sinara-hw/KASLI-DIOT/README.md

# Kasli
Kasli is a low-cost FPGA system board, capable of controlling 8 DI/OT peripheral modules. It can act as either an ARTIQ central core device or a satellite connected to the master via DRTIO.

## Design Files

Design files (schematics, PCB layouts, BOMs) can be found at [Kasli/Releases](https://github.com/sinara-hw/Kasli/releases).

## Wiki

More information can be found on the [wiki](https://github.com/sinara-hw/Kasli/wiki).
