sinara-hw/KASLI-DIOT/(list of files, drawings)

Other design files:
Bank_12_14_35.SchDoc
Bank_13_15.SchDoc
Bank_16_32_36.SchDoc
CLK_buffer_DRTIO_CDR.SchDoc
ClockRecovery.SchDoc
Ext_conn.schdoc
FPGA.schdoc
FPGA_I2C.SchDoc
FPGA_SDRAM.SchDoc
FPGAGTP.SchDoc
Kasli-DIOT.PrjPCB
Kasli-DIOT.SchDoc
PowerSupplies.SchDoc
SERVMOD control.SchDoc
SFP.SchDoc
USB_Serial_Quad.SchDoc
