sinara-hw/KASLI-DIOT/(threads)

Thread 2 (2024-03-22):

SCH and PCB review

gkasprow, 2024-03-22:
- [x] Move the bootloader button closer to the edge
- [x] Mark 12V connector as DNP or move it to the back - now it obstructs the airflow
- [x] Route I2C to the mezzanine in case we want to add additional SFPs

filipswit, 2024-03-24:
> Move the bootloader button closer to the edge

I don't think we can move it closer. It can't fit under the panel. We can optionally move it on TOP.

> Mark 12V connector as DNP or move it to the back - now it obstructs the airflow

We can try to move it to the right. For the first proto it will be needed to work on the table, later might be unmounted.
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

gkasprow, 2024-03-24:
Nie musisz odrazu pprawiac issues. Pawel bedzie robil review i pewnie i tak
cos wyjdzie.

niedz., 24 mar 2024, 20:45 użytkownik filipswit ***@***.***>
napisał:

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

filipswit, 2024-11-10:
12V Connector moved, in future can be marked as DNP
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

Closed 2024-11-10.

Thread 11 (2024-05-09):

Keep slot signals in the same bank

marmeladapk, 2024-05-09:
If that's not possible then keep clock capable signals with the same byte (so lvds0 and lvds1-7 in the same bank and lvds8 and lvds 9-15 in the same bank).

filipswit, 2024-05-09:
Can you point which exactly are wrongly connected?

marmeladapk, 2024-05-14:
On a closer look I didn't find any problems. I must have misread signal names in bank 2.

Closed 2024-05-14.

Thread 4 (2024-05-09):

Add a buffer to clock input

marmeladapk, 2024-05-09:
Then in case of an overdrive the buffer will fail, not the FPGA.

Similar thing should be done on Kasli and Kasli SoC as well IMO.

gkasprow, 2024-05-09:
we can also use anti-parallel diodes like it's done in WR switch

filipswit, 2024-11-06:
How about placing FIN1101?
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

jordens, 2024-11-06:
Is the performance of that buffer (phase noise, tempco, etc) known to be better than that of the FPGA?

gkasprow, 2024-11-06:
Just add 2 diodes like bav99 as limiter

filipswit, 2024-11-10:
ok, placed anti-parallel diodes BAV99
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

Closed 2024-11-11.

Thread 7 (2024-05-09):

Floating net label GND is disconnected from set pin

marmeladapk, 2024-05-09:
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

marmeladapk, 2024-05-09:
BTW maybe move byte net class definitions to net labels connected to sdrams, that way you'll get rid of floating net label warnings in which this error was hidden.

filipswit, 2024-11-05:
fixed

Closed 2024-11-10.

Thread 12 (2024-05-14):

Check impedance rules

marmeladapk, 2024-05-14:
Some differential pairs are assigned to D100 net class, some are assigned to Diff_100Ohm differential net class (via differential pair directive).

Moreover in PCB rules 100 Ohm rule is assigned to all differential pairs and takes precedence over 90 Ohm rule (causing usb to be routed as 100 Ohm).

Please switch to a single net class assignment type (either net class or differential net class). Personally I'd prefer to use differential net classes, as they can be assigned in differential routing rules without using custom queries and it logically separates differential pair and SE signals. Differential directive can also be applied to a directive blanket (this may help to declutter schematics btw).

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

filipswit, 2024-11-10:
Fixed.

Closed 2024-11-10.

Thread 15 (2024-05-22):

FPGA bank decoupling

marmeladapk, 2024-05-22:
- P1V5 has decoupling only for 1 bank, not for 2
- P2V5 is missing one set of decoupling capacitors (decoupling for 8 banks, not 9)

Otherwise MGT decoupling seems excessive given Xilinx' recommendations but is fine.

filipswit, 2024-11-10:
Added.

Closed 2024-11-10.

Thread 16 (2024-05-23):

Switch IC3 to P5V0_CLK input

marmeladapk, 2024-05-23:
It should provide 10-20 dB of additional PSRR.

filipswit, 2024-11-06:
Yes, but we draw around 300mA from P2V5, while powering it from 5V we would have 750mW losses. In my opinion thats a lot.

Closed 2024-11-10.

Thread 17 (2024-05-23):

LVCMOS input can't be AC coupled for Si53312

marmeladapk, 2024-05-23:
Also DNP R12 in CMOS variant

Datasheet says that for LVCMOS source and sink vdd should be equal. We have P2V5 for source and P3V3 for sink. But we still clear the bar for V_ih in single ended mode.

filipswit, 2024-11-05:
Do we actually need CMOS variant? I don't think we have ever used CMOS oscillators

gkasprow, 2024-11-06:
No. Just one single variant

Pozdrawiam / Best regards
G.Kasprowicz
________________________________
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

filipswit, 2024-11-10:
It's not valid since we leave one single variant.

Closed 2024-11-10.

Thread 19 (2024-05-23):

Remove IC5

marmeladapk, 2024-05-23:
And place IC31.

I think this is the best time to switch to a dedicated eeprom I2C bus and free up address space on shared i2c bus.

filipswit, 2024-11-10:
IC31 has now separated I2C_EEPROM tied to FPGA and I2C switch.

Closed 2024-11-10.

Thread 21 (2024-05-23):

C292 and C197 are placed in the middle of nowhere

marmeladapk, 2024-05-23:
FPGA_I2C

One of them should be removed (it was for removed I2C mux) and other capacitors should be placed near respective ICs.

filipswit, 2024-11-10:
Fixed

Closed 2024-11-10.

Thread 22 (2024-05-23):

Change IC21 to 93LC56B

marmeladapk, 2024-05-23:
USB

This will allow us to use Vivado programming and debugging tools when needed.

https://docs.amd.com/r/en-US/ug908-vivado-programming-debugging/Programming-FTDI-Devices-for-Vivado-Hardware-Manager-Support

filipswit, 2024-11-05:
Replaced with 93LC56B-I/OT

Closed 2024-11-10.

Thread 25 (2024-06-20):

Silk to solder mask clearance

marmeladapk, 2024-06-20:
Rule checking was disabled and generates DRC errors when enabled.

Easiest solution would be to use Tools->Silkscreen preparation option.

filipswit, 2024-11-10:
Thanks! That feature is cool!

Closed 2024-11-10.

Thread 27 (2024-06-20):

Can via templates be combined?

marmeladapk, 2024-06-20:
There are a few via templates in use. Can v60h30 be changed to v50h20? That way we'll have one less hole size, which should be a bit cheaper to manufacture.

filipswit, 2024-11-06:
I'dont think it is worth changing. There will be the same amount of holes anyway, and bigger one are for higher currents.

Closed 2024-11-10.

Thread 31 (2024-06-25):

wrong buck voltage

gkasprow, 2024-06-25:
swap R37 and R39

marmeladapk, 2024-06-27:
P2V5 is also wrong

filipswit, 2024-11-10:
Fixed.

Closed 2024-11-10.

Thread 36 (2024-07-02):

DDR routing

marmeladapk, 2024-07-02:
Highlighted lines are too close. Saturn says that over 1 cm there could be 0,5V of crosstalk. You can use bottom layer to route 3 signals, Altium calculates via length but it won't take into account the propagation delay difference between different layers, though it's pretty minor difference (6.23 ps/mm vs 6.86 ps/mm). Alternatively if you use matched length with delay values it won't calculate via delay :/

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

There's also 2 lines like that in BYTE2.

marmeladapk, 2024-07-03:
Also there are some lines on layer 5 and 6 that run parallel to each other over long distances and don't have a plane inbetween. Maybe move them around a bit?

filipswit, 2024-11-10:
Made bigger separation on L6 wherever was possible, and moved traces ln L5 and L6 so they mostly don't run in parallel.

Closed 2024-11-10.

Thread 37 (2024-07-02):

Artifacts from cooper balancing generation

marmeladapk, 2024-07-02:
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

On the bottom of the board. Probably keep out lines didn't reach here.

filipswit, 2024-11-11:
FIxed.

Closed 2024-11-11.

Thread 39 (2024-07-02):

Via connection

marmeladapk, 2024-07-02:
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

This via is not connected to P3V3.

marmeladapk, 2024-07-02:
![Uploading image.png…]()

And these are not connected to P1V5.

filipswit, 2024-11-10:
- P3V3 via has connection on bottom, we can't move this plane becaus it is reference for DDR.
- P1V5 fixed

Closed 2024-11-10.

Thread 40 (2024-07-03):

Reference plane change vias

marmeladapk, 2024-07-03:
- [ ] Add via here:
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

In many places there's only one via for per differential pair when changing reference plane. Too many to list here.

- [ ] Add  capacitors here
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

- Changes to/from layer 6 are problematic since there's a P3V3 plane closest but there are no capacitors fir this change (e.g. between layer 1 and layer 6 there should be a capacitor nearby from P2V5 to P3V3.)

filipswit, 2024-11-10:
- Added vias whereber it was possible.
- Added capacitor.
- Made some changes in power planes, so now  L6 has P2V5 under

Closed 2024-11-10.

Thread 41 (2024-07-03):

Increase width of P12V0 fused

marmeladapk, 2024-07-03:
Mezzanine may draw 180 W @ 12 V (15 A). IS the fuse sized correctly?

Closed 2024-07-03.

Thread 42 (2024-08-31):

SERVMOD control

gkasprow, 2024-08-31:
At the moment, SERVMOD is controlled using FPGA GPIOs
This means I2C resources of the DIOT crate wouldn't be available from USB I2C.
This would make crate configuration identification impossible without a dedicated FPGA bitstream
I'd connect them (maybe in parallel) to I2C extender.

gkasprow, 2024-09-03:
The same applies to RST_N; we need to make sure we can enable power supplies of peripheral boards
The RST_N must be low by default before FPGA is configured.
It needs to be strong enough to hold pullups of 8 modules

gkasprow, 2024-11-05:
Since existing I2C expanders cannot properly steer a 200-ohm load in DIOT devices, we need to add something that buffers them.
Let's use existing (in the BOM) 16-bit expanders followed by LVC245, which provides 24mA of current capability. At a 3.3V supply, it will deliver more than 2.4V at such a load.
Please connect it in the following way:
Expander Port 0 -> 1k series resistors ->HC245 -> 47k pullups-> SERVMODs
Expander Port 1 -> HC245 OE, DIR.
This way, we would be able to read which SERVMODs are pulled by 200Ohm to GND and then drive them high to enable configuration readout.
Expander Port 1 should also drive RST_N
Keep existing connections with FPGA via DNP resistors

filipswit, 2024-11-10:
Added, with default PCA9539
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

gkasprow, 2024-11-10:
Are you sure HC245 has enough current capability to steer 200R to the proper logic level?

Closed 2024-11-11.

Thread 43 (2025-02-03):

Prototype v1.0 testing

kaolpr, 2025-02-03:
- Power supplies OK.
- JTAG chain enumeration fails with HS-3 on default frequency (15 MHz). Works reliably on 5 MHz.
- After programming FTDI to be usable in Vivado (`program_ftdi`) checked JTAG chain from on-board FTDI, it works stable with default JTAG frequency (15MHz).
- In crate IBERT @ 3.125G  with peripheral slots 2..7 populated and SFP Loopbacks:
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
- In crate IBERT @ 3.125G  with peripheral slots 0..5 populated and SFP Loopbacks:
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

Thread 44 (2025-02-07):

Handle collides PCB

kaolpr, 2025-02-07:
It's not that it is unusable, but may introduce unnecessary tension when front panel is mounted.

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

kaolpr, 2025-02-07:
@gkasprow Please check if the same issue is not present in DIOT Peripheral template.

Thread 49 (2025-03-10):

Mechanical Issues

gravelpitman, 2025-03-10:
Hi,

1. The SFP cage is too high. If we make the panel opening like in the Amphenol datasheet (https://cdn.amphenol-cs.com/media/wysiwyg/files/drawing/ue78bx12700xx1.pdf), we will not leave enough material.

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

2. The PCB shape is incorrect. There is interference between the PCB and the FB bottom bracket.

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

The red color indicates interference

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
Please follow these guidelines when drawing the front edge of the board

1. Goldpin connector IMO is to close to SBC PCB

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
I would move this connector 1mm in the X+ axis

gkasprow, 2025-03-10:
@gravelpitman please add this issue to all other DI/OT boards

Thread 50 (2025-03-13):

No pull-up on monitoring I2C bus

kaolpr, 2025-03-13:
There should be pull-ups on the monitoring I2C bus. Latest (V4) version of DIOT SB has them. They are also on the STM System Board.

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

See https://ohwr.org/project/diot-sb-zu/-/issues/358

Thread 51 (2025-03-24):

CFG_PUDC_B should be pulled up

kaolpr, 2025-03-24:
To follow Kasli, `CFG_PUDC_B` should be pulled high. Now there are two resisitors (up and down), but both are assembled in the only defined variant:

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

UG470:

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

Thread 52 (2025-03-25):

Invalid FCS_B connection

kaolpr, 2025-03-25:
`FCS_B` is connected to some random pin P6:

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

whereas it should be connected to Y27 that is specifically denoted as `FCS_B`:

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

As a result, the device can't be booted from flash and using normal tools for flashing (like proxy bitstream) is impossible. However, after building modified proxy bitstream, the device can be flashed, but not booted.

Thread 55 (2025-06-17):

The AC coupling caps on SFP GT lanes are unnecessary according to SFP(+) spec

MorganTL, 2025-06-17:
see [kasli-soc/#83](https://github.com/sinara-hw/Kasli-SOC/issues/83)
