sinara-hw/KASLI-DIOT/(commit log)

2024-02-21 Preliminary layout.
    [Bank_1.SchDoc, Bank_2.SchDoc, Bank_3.SchDoc, CLK_buffer_DRTIO_CDR.SchDoc, ClockRecovery.SchDoc, Cpcis_connectors_P4_P5_P6.SchDoc, FPGA.schdoc, FPGAGTP.SchDoc]
2024-11-11 v1.0rc3 fixes after review
    [Bank_1.SchDoc, Bank_12_14_35.SchDoc, Bank_13_15.SchDoc, Bank_16_32_36.SchDoc, Bank_2.SchDoc, Bank_3.SchDoc, CLK_buffer_DRTIO_CDR.SchDoc, ClockRecovery.SchDoc]
